iamAkshayrao/LQR-BalanceBot/README.md

# LQR-BalanceBot
LQR-BalanceBot is a two wheel self-balancing robot, based on Arduino Mega. It uses Linear-Quadratic-Regulator, an optimal controller which optimizes a cost function using energy-based method to give optimum gains according to our requirements. A six-state variable state space model has been designed to control position, velocity, yaw (using Quadrature encoders), and tilt angle (using GY-87 sensor) of the bot.

### Video Demonstration ###
https://youtu.be/7lbDvhHPumI

### Results Snapshots

**Traversing slope**

<p float="left">
  
  
    

</p>

**Object pick up and drop**

<p float="left">
  
  
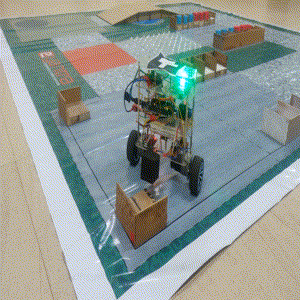
[picture p1: Images/thrid_cut.gif]
    

</p>

**Position hold**

<p float="left">
  

</p>

### Control Architecture
<p float="left">
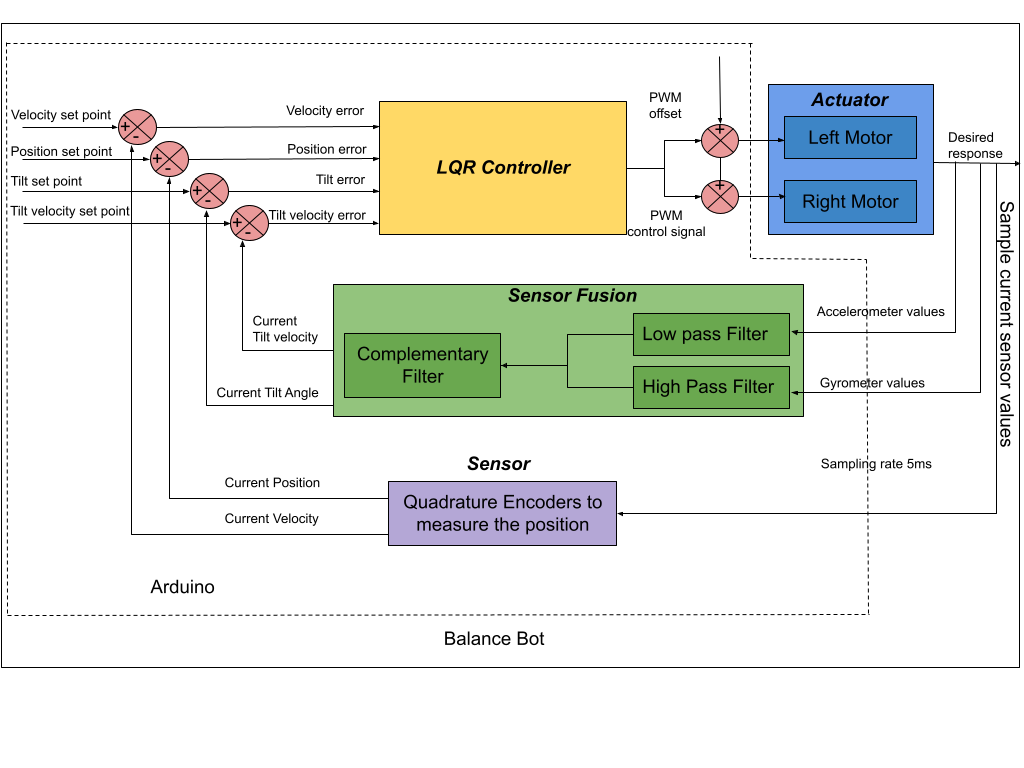
[picture p2: Images/Optimal Control (5).png]
architecture
  
</p>

### Contributors
Akshay, Ali, Ankit, Rehab

### Repository Contents ###
- **Libraries:** Contains MPU and I2C libraries
- **code:** Contains the code for controlling the bot
- **Model:** Contains code files for Mathematical modelling of Robot 
- **Report:** Documentation on the working of the robot and all the task submissions
- **Images:** contains images
