iamAkshayrao/LQR-BalanceBot/References/papers.md

Frankovský, P., Dominik, L., Gmiterko, A., Virgala, I., Kurylo, P. and Perminova, O.. "Modeling of Two-Wheeled Self-Balancing Robot Driven by DC Gearmotors" International Journal of Applied Mechanics and Engineering, vol.22, no.3, 2017, pp.739-747. https://doi.org/10.1515/ijame-2017-0046

Dynamic model of robots: Lagrangian approach Prof. Alessandro De Luca

Adeel, Umar & Alimgeer, Khurram & Inam, Omair & Hameed, Ayesha & Qureshi, Mahmood & Ashraf, Mehmood. (2013). Autonomous Dual Wheel Self Balancing Robot Based on Microcontroller. Journal of Basic and Applied Scientific Research. 3. 843-848. 

https://www.semanticscholar.org/paper/Self-Balancing-Bot-Using-Concept-of-Inverted-Tripathy/ac0a30532ad617de4cc535258583858606950cc2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

Soumya Ramesh. Article: Modelling of Geared DC Motor and Position Control using Sliding Mode Controller and Fuzzy Sliding Mode Controller. IJCA Proceedings on International Conference on Innovations In Intelligent Instrumentation, Optimization and Electrical Sciences ICIIIOES(13):16-23, December 2013

Siradjuddin, Indrazno & Setiawan, Budhy & Fahmi, Ahmad & Amalia, Zakiyah & Erfan, ROHADI. (2017). State space control using LQR method for a cart-inverted pendulum linearised model. 17. 119-126. 

Lundberg, Kent. (2009). History of Inverted-Pendulum Systems. IFAC Proceedings Volumes. 42. 131-135. 10.3182/20091021-3-JP-2009.00025. 

Goher, Khaled & Tokhi, Mohammad. (2010). A New Configuration of Two-Wheeled Inverted Pendulum: A Lagrangian-Based Mathematical Approach. 

https://ctms.engin.umich.edu/CTMS/index.php?example=InvertedPendulum&section=SystemModeling

https://www.coursehero.com/file/12214161/InvertedPendulumOnCartSolution/

The dynamics of a Mobile Inverted Pendulum (MIP). Saam Ostovari, Nick Morozovsky, Thomas Bewley. UCSD Coordinated Robotics Lab.

https://www.mathworks.com/matlabcentral/fileexchange/19147-nxtway-gs-self-balancing-two-wheeled-robot-controller-design
