iamAkshayrao/LQR-BalanceBot/Report/BP_eYRC#9_Task 3.3.pdf

# Biped Patrol

## Task 3.3: Think & Answer

Team Id | 9
College | B.M.S. College Of Engineering
Team Leader Name | Akshay S Rao
e-mail | akshayrao.ec17@bmsce.ac.in
Date | January 15, 2020
Question No. | Max. Marks | Marks Scored
Q1 | 10
Q2 | 20
Q3 | 5
Q4 | 5
Q5 | 5
Q6 | 10
Q7 | 15
Q8 | 8
Q9 | 4
Q10 | 8
Q11 | 10
Total | 100

1

# Biped Patrol

## Task 3.3: Think & Answer

Instructions:

- There are no negative marks.
- Unnecessary explanation will lead to less marks even if answer is correct.
- If required, draw the image in a paper with proper explanation and add the snapshot in your corresponding answer.

Q 1. Describe hardware design for the Medbot, your team is constructing. Describe various
parts with well labeled image. Give reasons for selection of design. | [10]

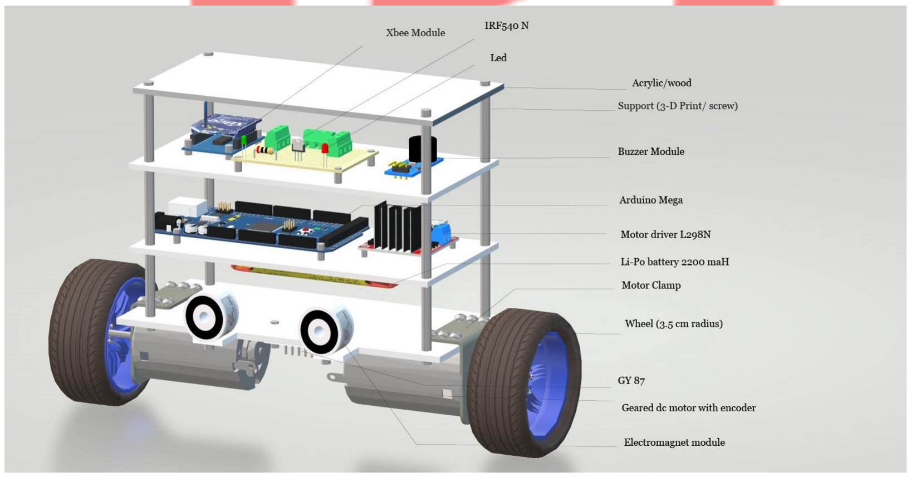
[picture p3: figure]

Figure 1: 3D Model of Medbot

2

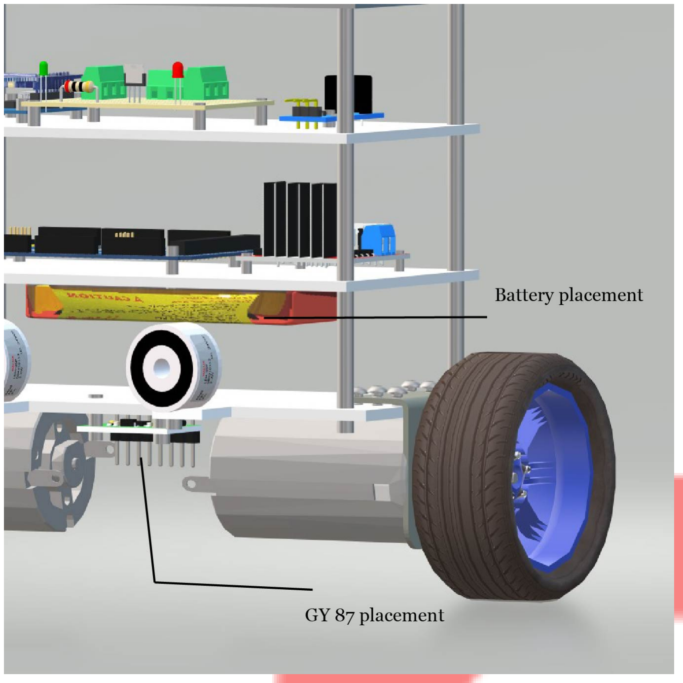
[picture p4: figure]
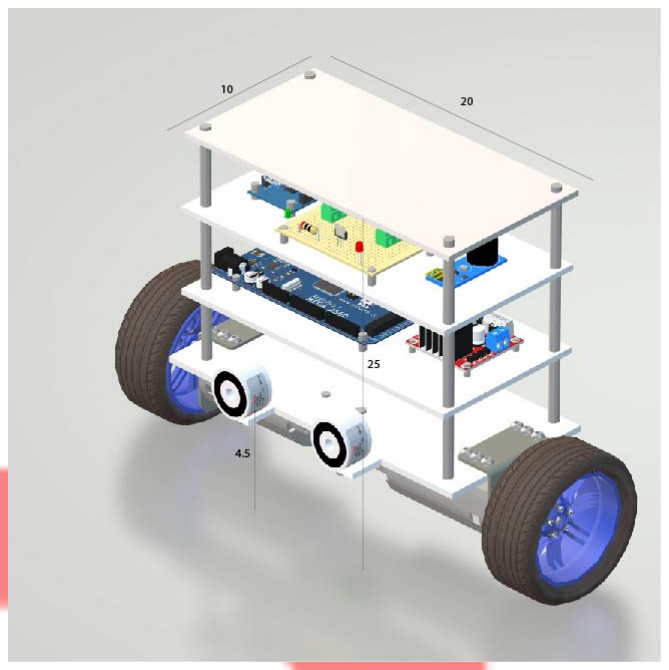
[picture p5: figure]

(a) Gyro and Battery Placement | (b) Dimensions

Figure 2: MedBot from different angles

A 1. Body: Stacked type of design is employed. This helps in varying the position of centre of mass and also helps in programming point of view since the bot has to be tuned many times. To reduce the weight of the body for torque requirement acrylic material is used. The support material is a 3-D printed material.Stack is of size 20x10,The total height of the bot is around 25cm from the bottom.

Gyroscope Placement:GY-87 sensor is placed at the bottom stack along the axis of centre of mass and parallel to the wheel axis.The values measured by the gyroscope is not affected by the placement of the sensor, as it will vary by the same amount at all points on the robot. As the distance from the ground increases, linear acceleration and vibrations, measured at higher points, increases. This could lead to false readings on the accelerometer. Therefore, the sensor is placed at the bottom.

Centre of mass: Mass is distributed in such a way that the position of centre of mass is as low as possible.If the position is too high its stable to disturbances but torque requirement will be very high and lower recovery angle range.By lowering the position we get higher recovery angle and has lesser chance of toppling.From the calculation ,it is at a height of around 14 cm

Electromagnet placement: Electromagnet is placed at the bottom at a height of 4.5cm from the bottom. The centres of the supply iems are at a height of 5cm and 4cm from the arena surface. The average of these height is considered for electromagnet position.

3

Q 2. In Task 1.2, you were asked to model different systems such as Simple Pulley, Complex Pulley, Inverted Pendulum with and without input and stabilizing the unstable equilibrium point using Pole Placement and LQR control techniques. There you had to choose the states; Derive the equations (usually non-linear), find equilibrium points and then linearize around the equilibrium points. You were asked to find out the linear system represented in the form

X˙ (t) = AX(t) + BU(t) | (1)

Where X(t) is a vector of all the state,i.e., X(t) = [x1(t), x2(t), . . . , xn(t)]T , and U(t) is the
vector of input to the system, i.e. U(t) = [u1(t), u2(t), . . . , um(t)]T
. A is the State Matrix & B is the Input Matrix.

In this question, you have to choose the states for the Medbot you are going to design. Model the system by finding out the equations governing the dynamics of the system using Euler-Lagrange Mechanics. Linearize the system via Jacobians around the equilibrium points representing your physical model in the form given in equation 1.
Note: You may choose symbolic representation such as Mw for Mass of wheel, etc. | [20]

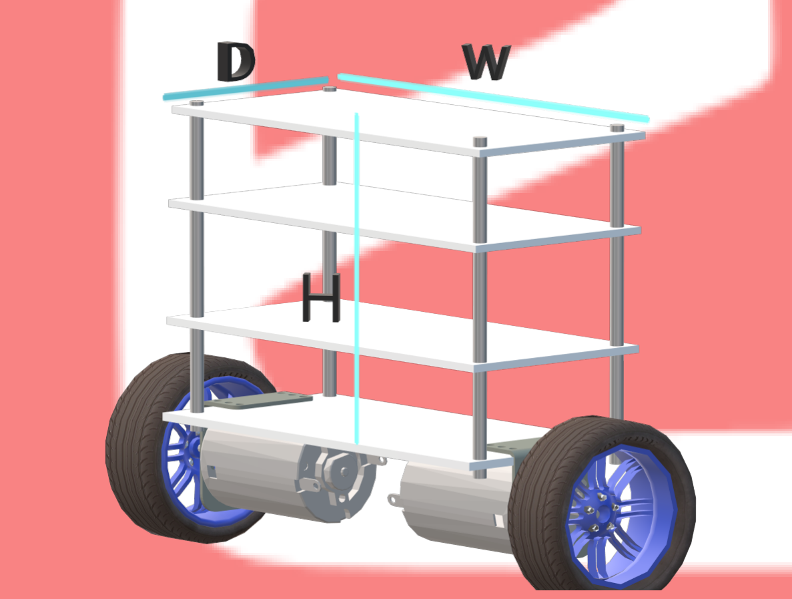
[picture p6: figure]

Figure 3: Medbot

4

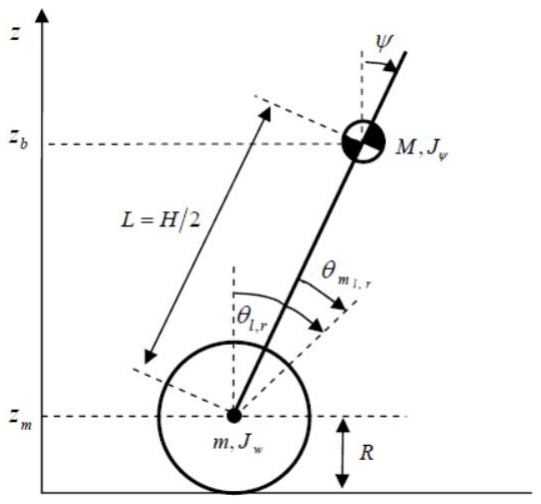
[picture p7: figure]
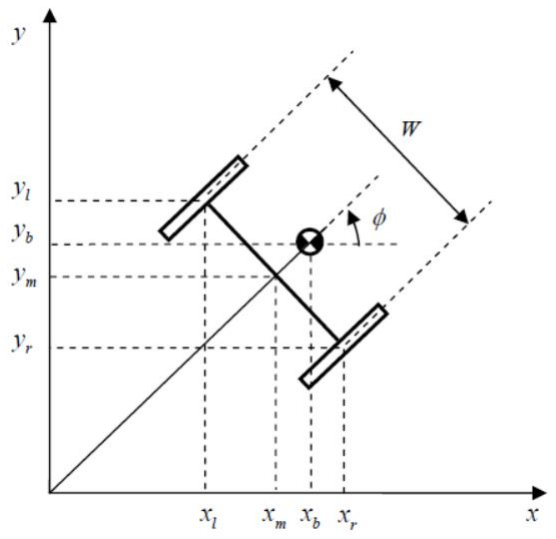
[picture p8: figure]

(a) Top view | (b) Side view

Figure 4: MedBot from different angles

A 2. ψ : body pitch angle; θl,r : wheel angle(l, r indicates left and right)

Physical parameters of the model are the following.
Parameter | Units | Description
g = 9.81 | [m / sec² ] | Acceleration due to gravity
m | [kg] | Wheel mass
R | [m] | Wheel radius
JW | [kg m² ] | Wheel inertia moment
M | [kg] | Body weight
W | [m] | Body width
D | [m] | Body depth
H | [m] | Body height
L | [m] | Distance of the center of mass from the wheel axle
Jψ | [kgm² ] | Body pitch inertia moment
Jφ | [kgm² ] | Body yaw inertia moment
Jm | [kgm² ] | DC motor inertia moment
Rm | [Ω] | DC motor resistance
Kb | [V sec /rad] | DC motor back EMF constant
Kt | [Nm / A] | DC motor torque constant
n | | Gear ratio
fm | | Friction coefficient between body and DC motor
fπ | | Friction coefficient between wheel and floor

5

Equations of Motion Of Two-Wheeled Inverted Pendulum(Medbot).
We can derive equations of motion of two-wheeled inverted pendulum by the Lagrangian method based on the coordinate system in Figure 4. If the direction of two-wheeled inverted pendulum is x-axis positive direction at t = 0, each coordinates are given as the following. (θ, φ) =
1
2

(θl + θr)

R
W

(θr − θl)

(xm, | ym, | zm) = Z
x˙ mdt, | Z
| | | | | y˙mdt, | R
, | ( ˙xm, | y˙m) = (R ˙θ cos φ R ˙θ sin φ)

(xl
, | yl
, | zl) =
xm −
| | | | | W
| | | | | 2
sin φ, | ym +
| | | | | | W
| | | | | | 2
cos φ, | zm

(xr, | yr, | zr) =
xm +
| | | | | W
| | | | | 2
sin φ, | ym −
| | | | | | W
| | | | | | 2
cos φ, | zm

(xb, | yb, | zb) = (xm + L sin ψ cos φ, | ym + L sin ψ sin φ, | zm + L cos ψ)

The translational kinetic energy T1, the rotational kinetic energy T2, the potential energy U
are T1 = | 1
| 2 m
| | x˙
| | 2
l + ˙y

2
| | | | l + ˙z

2
l
| | | | | +
| | | | | 1
| | | | | 2 m
| | | | | x˙
| | | | | 2 r + ˙y
| | | | | 2
r + ˙z
| | | | | | 2 r
| | | | | | + | 1
| | | | | | | 2 M
x˙

2
b + ˙y

2
b + ˙z

2
b

T2 = | 1
| 2 Jw | ˙θ
| | 2 l + | 1
| | | 2 Jw | ˙θ
| | | | 2 r + | 1
| | | | | 2 Jψψ˙ ² +
| | | | | 1
| | | | | 2

Jφφ˙² +

| | | | | | 1
| | | | | | 2 n
| | | | | | 2 | Jm
˙θl − ψ˙

2
+

1
2

n

2
Jm
˙θr − ψ˙

2

U = Mgzb

The fifth and sixth term in T2 are rotation kinetic energy of an armature in left and right DC motor. The Lagrangian L has the following expression.
L = T1 + T2 − U

We use the following variables as the generalized coordinates.
θ | : Average angle of left and right wheel
ψ | : Body pitch angle
φ | : Body yaw angle

The state variables are
[x1 | x2 | x3 | x4 | x5 | x6] = [θ ψ φ | ˙θ ψ˙ | φ˙
]

Lagrange equations are the following.
d

dt
∂L
∂

˙θ

−

∂L
∂θ = Fθ

d

dt
∂L
∂ψ˙
−

∂L
∂ψ = Fψ

d

dt
∂L
∂φ˙
−

∂L
∂φ = Fφ

6

The following equations are found by evaluating the above expressions.

(2m + M)R

2 + 2Jw + 2n

2
Jm

¨θ +
MLR cos ψ − 2n

2
Jm

ψ¨ − MLRψ˙ ²
sin ψ = Fθ
MLR cos ψ − 2n

2
Jm

¨θ +

ML² + Jψ + 2n

2
Jm

ψ¨ − MgL sin ψ − ML²φ˙²
sin ψ cos ψ = Fψ
1
2

mW² + Jφ +

W²
2R²
Jw + n

2
Jm

+ ML²

sin² ψ

φ¨ + 2ML²ψ˙φ˙ sin ψ cos ψ = Fφ

In consideration of DC motor torque and viscous friction, the generalized forces are given as the following
(Fθ, | Fψ, | Fφ) =
Fl + Fr, | Fψ,

W
2R

(Fr − Fl)

Fl = nKtil + fm

ψ˙ − ˙θl
− fw

˙θl

Fr = nKtir + fm

ψ˙ − ˙θr
− fw

˙θr

Fψ = −nKtil − nKtir − fm

ψ˙ − ˙θl
− fm
ψ˙ − ˙θr

where il,r is the DC motor current. We cannot use the DC motor current directly in order to control it because it is based on PWM (voltage) control. Therefore, we evaluate the relation between current il,r and voltage vl,r using DC motor equation. If the friction inside the motor is negligible, the DC motor equation is generally as follows

Lmil,r = vl,r + Kb

ψ˙ − ˙θl,r
− Rmil,r

Here we consider that the motor inductance is negligible and is approximated as zero. Therefore the current is

il,r =

vl,r+Kb(ψ˙− ˙θl,r)

Rm

The generalized force can be expressed using the motor voltage. Fθ = α (vl + vr) − 2 (β + fw)

˙θ + 2βψ˙

Fv = −α (vl + vr) + 2β ˙θ − 2βψ˙

Fφ =

W
2R

α (vr − vl) −

W²
2R²

(β + fw) φ˙

α =

nKt
Rm

, β =

nKtKb
Rm

+ fm

To find the expressions for ¨θ ψ¨ φ¨ the following notations are used. A = (2m + M)R

2 + 2Jw + 2n

2
Jm + 2(β + fw)
B = MLR cos ψ − 2n

2
Jω
C = ML² + Jψ + 2n

2
Jm

D =

1
2

mW² + Jφ +

W²
2R²
Jω + n

2
Jm

+ ML²

sin² ψ

7

The derivatives of the state variables without linearization are expressed by ˙θ =

dθ
dt
ψ˙ =

dψ
dt
φ˙ =

dφ
dt

¨θ =

Fθ + MLRψ˙ 2
sin ψ
(ML² + Jψ + 2n

2Jm) − B

h
Fψ + MgL sin ψ + ML²φ˙2
sin ψ cos ψ

i

AC − B²

ψ¨ =

A

h
Fψ + MgL sin ψ + ML²φ˙2
sin ψ cos ψ

i
− B

h
Fθ + MLRψ˙ 2
sin ψ

i

AC − B²

φ¨ =

W
2R

α (vr − v1) −

W²
2R² (β + fw) − 2ML²

sin ψ cos ψφ˙ψ˙

D

From the above expressions Jacobian is given by J =

0 | 0 | 0 | 1 | 0 | 0
0 | 0 | 0 | 0 | 1 | 0
0 | 0 | 0 | 0 | 0 | 1
0 J(1, 1) 0 J(1, 2) J(1, 3) J(1, 4) 0 J(2, 1) 0 J(2, 2) J(2, 3) J(2, 4)
0 J(3, 1) 0 | 0 | J(3, 2) J(3, 3)

J(3, 1) = −ML²Dψ˙φ˙2 cos 2ψ−(numerator(φ¨))(ML²

sin 2ψ)

D²

J(3, 2) = −2ML²φ˙ sin ψ·cos ψ D
J(3, 3) = −W²
2R² (β + fw) − 2ML²ψ˙ cos ψ sin ψ/D

J(2, 4) = 2AML²φ˙ sin ψ cos ψ
AC−B²
J(2, 3) = −2β(A+B)−2BMLRψ˙ sin ψ AC−B²
J(2, 2) = 2B(β+fω)+2Aβ
AC−B²
J(1, 2) = −2(β+fω)C−2βB
AC−B²
J(1, 3) = (2β+2MLRψ˙ sin ψ)C+2βB AC−B²
J(1, 4) = −2ML²sinψ cos ψφB˙ AC−B²
J(2, 1) = ((AC−B²

)[A(MgL cos ψ−4ML²φ˙2 cos 2ψ)−B(MLRψ˙ 2 cos ψ)+[Fθ+MLRψ˙ 2
sin ψ][MLR sin ψ]−
(numerator(ψ¨)(2B)(MLRSinψ))/[AC − B² ]

2
J(1, 1) = (AC − B²
)

h
MLRψ˙cos²ψ (ML² + Jψ + 2n
2Jm) − B

h
MgL cos ψ + 2ML²φ˙2 cos(2ψ)

i
+

h
Fψ + MgL sin ψ +

(numerator(

¨θ))(2BMLR sin ψ)]/[AC − B² ]

2

Linearization and State-Space Representation
The derivatives of the state variables are equated to zero to find the equilibrium points. The

8

equilibrium points found are when pitch angle ψ is 0 or π from the positive z axis and the derivatives of the state variables are 0.
Since point ψ = 0 from vertical is unstable equilibrium,Jacobian is linearized around this point.After substituting the equilibrium points in the Jacobian ,the following state space representation is obtained.

X˙ = A0X + B0U

where, X =

θ ψ φ ˙θ ψ φ >

U =

vl vr

>

E =

(2m + M)R² + 2Jv + 2n

2Jm MLR − 2n 2Jm
MLR − 2n
2Jm | ML² + Jψ + 2n

2Jm

A0 =

0 | 0 | 0 | 1 | 0 | 0
0 | 0 | 0 | 0 | 1 | 0
0 | 0 | 0 | 0 | 0 | 1
0 x(1, 1) 0 x(1, 2) x(1, 3) | 0
0 x(2, 1) 0 x(2, 2) x(2, 3) | 0
0 | 0 | 0 | 0 | 0 | x(3, 1)

x(1, 1) = −gMLE(1,2)
det(E)
x(1, 2) = −2[(β+fw)E(2,2)+βE(1,2)] det(E)
x(1, 3) = 2β[E(2,2)+E(1,2)] det(E)
x(2, 1) = gMLE(1,1)
det(E)
x(2, 2) = 2[(β+fw)E(1,2)+βE(1,1)] det(E)
x(2, 3) = −2β[E(1,1)+E(1,2)] det(E)
x(3, 1) =

W2
2R2

(β+fw)

1

2mW²+Jφ+ W2
2R2

(JW +n²Jm)

B0 =

0 | 0
0 | 0
0 | 0
B0(4) | B0(4)
B0(5) | B0(5)
−B0(6) B0(6)

B0(4) = α[E(2,2)+E(1,2)]
det(E)
B0(5) = −α[E(1,1)+E(1,2)]
det(E)
B0(6) = | W α
2R

h
1

2mW²+Jφ+ W2
2R2

(Jw+n²Jm)

i

9

Q 3. Equation 1 represents a continuous-time system. The equivalent discrete time system is represented as:
X(k + 1) = AdX(k) + BdU(k) | (2)

Where X(k) is a measure of the states at kth sampling instant,i.e., X(k) = [x1(k), x2(k), . . . , xn(k)]T
,
and U(k) is the vector of input to the system at kth sampling instant, i.e. U(k) = [u1(k), u2(k), . . . , um(k)]T .
Ad is the Discrete State Matrix & Bd is the Discrete Input Matrix.

What should be the position of eigen values of Ad for system to be stable.
Hint: In frequency domain, continuous-time system is represented with Laplace transform and
discrete-time system is represented with Z transform. | [5]

A 3. The Laplace transform in frequency domain is used to construct any aperiodic finite signal using growing or damped complex exponentials of continuous frequencies from zero to infinity. The laplace tranform is given by

F(s) = R ∞
0

f(t)e

−stdt

where, s = σ + jω

We can find the system transfer function using the state space equations under zero state conditions.The real part of the roots of the system transfer function should be negative, so that after convolution the output of the system is finite thereby meaning stable.

In z domain it is similar case but the continuous time signal is sampled with a period Ts, but z = rejω , so here the abs(z) should be lesser than one so that system is stable.

X(z) = Z{x[n]} =

P∞
n=−∞ x[n]z

−n

Hence the eigenvalues represent the s and z values of continuous and discrete case respectively of the system transfer function under zero state condition. Therefore for discrete case, the abs(eigenvalues) should be lesser than one for the system to be stable.

If the real part of the s parameter is zero then it corresponds to the Y axis in the σ − jω plane which corresponds to the unit circle in the z plane.

The system is stable if Ts>0 and the eigenvalues are within the unit circle, as determined by this statement:

10 all(abs(eig(Ad))) < 1 where Ad = T A0 + I considering Euler’s transformation.

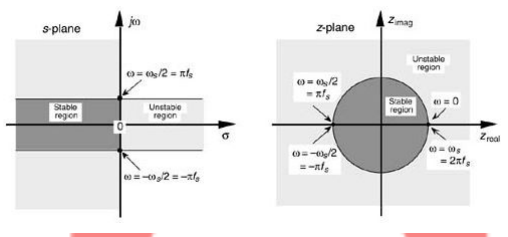
[picture p9: figure]

Q 4. Will LQR control always works? If No, then why not? and if Yes, Justify your answer.
Hint: Take a look at definition of Controllable System. What is controllability? | [5]

A 4. No. LQR controllers are controllers that provide input that can steer a particular system from some initial point at x0 at t=0 to any state xf inal at t=n. If the controllability matrix has rank less than the number of state variables then the system is said to be uncontrollable. Hence if system is controllable then only can we use LQR controllers. Also when the the specifications of the components do not meet the requirement of the LQR, LQR might work but the desired state cannot be obtained and hence it will become uncontrollable.

Q 5. For balancing robot on two wheel i.e. as inverted pendulum, the center of mass should
be made high or low? Justify your answer. | [5]
A 5. | • The torque equation is given by | τ = MgL sin θ.
- Here Mg is weight of the body and L is the distance of the centre of mass from the wheel
| axis.
- According to the equation when L increases,torque applied by the body increases, to counter this torque ,the torque requirement of motor increases. Hence to reduce the torque requirement the position of centre of mass is made low in our design.
- Also from the equation ,θ can be more as L is made less, so the bot can balance itself for
| large angular displacement.

11

Q 6. Why do we require filter? Do we require both the gyroscope and the accelerometer for
measuring the tilt angle of the robot? Why? | [10]

A 6. We require filter to remove noise signals which is induced by the mechanical vibrations and also to complement for the disadvantage present in acquiring signals in accelerometer and gyroscope.

Accelerometer
An accelerometer is used to measure the inertial force which is directed in the opposite direction of the acceleration vector. It measures force and not acceleration but it happens that acceleration also causes an inertial force which is captured by the force detecting mechanism of the accelerometer. We need to calculate pitch using the accelerometer which can be done using the formula

pitch = atan2(accx, sqrt(accy² + accz² ))

Disadvantages.

1. Pure yaw angles cannot be calculated from just a accelerometer because Z will be perfectly perpendicular to the plane of motion.
2. Accelerometer experiences translational accelerations too. These will add additional acceleration values and so the orientation values obtained won’t be the actual one.
3. Accelerometer alone used to measure the pitch angle will be very noisy. The platform is horizontal, but the motors are causing it to accelerate forward. The accelerometer cannot distinguish this from gravity.

Hence we use a low pass filter to filter out the short duration horizontal acceleration so that only the long term acceleration is captured that is gravity. However, the con of this is that Angle measurement will lag due to the averaging. The more it is filtered, the more it will lag. Hence a sudden change or a large change cannot be detected easily since it is averaged before.

Gyrometer
The gyroscope measures the angular velocity of the body frame with respect to the inertial frame, expressed in the body frame. Hence to find the angular displacement, we have to integrate the angular velocity.

Advantages and disadvantages

1. The gyrometer provides the orientation estimates at high sampling rates which are accurate on a short time scale but drift over longer time scales due to integration drift.

12

2. If we measure a quantity which is zero using a non-perfect sensor, in case our measurements are corrupted by a constant bias, integration of these measurements will lead to a signal which grows linearly with time. If the sensor instead measures a zero-mean white noise signal, the expected value of the integrated measurements would be zero, but the variance would grow with time.

If we pass the angle obtained through a high pass filter we will obtain value for the angle measurement but it will be plagued by the variance due noise.

Hence we use a complementary filter where we pass the angle estimated by the accelerometer through a low pass filter (good estimation of the static conditions) and gyrometer through a high pass filter(good estimation of the dynamic conditions) and combine the results.

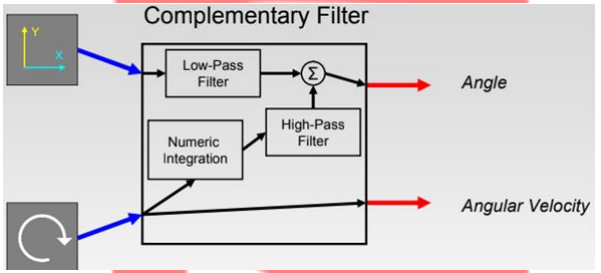
[picture p10: figure]

Figure 5: Complementary filter to obtain angular displacement and velocity

Q 7. What is Perpendicular and Parallel axis theorem for calculation of Moment of Inertia?
Do you require this theorem for modelling the Medbot?Explain Mathematically. | [15]

13

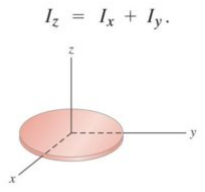
[picture p11: figure]

(a) Parallel Axis theorem | (b) Perpendicular Axis Theorem

Figure 6

A 7. Parallel Axis Theorem
Suppose a body of mass m is rotated about an axis z passing through the body’s centre of gravity. The body has a moment of inertia Icm with respect to this axis. The parallel axis theorem states that if the body is made to rotate instead about a new axis z

0 which is parallel
to the first axis and displaced from it by a distance d, then the moment of inertia I with respect to the new axis is related to Icm by
I = Icm + md²

Explicitly, d is the perpendicular distance between the axes z and z

0

Perpendicular Axis Theorem
The perpendicular axis theorem states that the moment of inertia of a plane lamina about an axis perpendicular to the plane of the lamina is equal to the sum of the moments of inertia of the lamina about the two axes at right angles to each other, in its own plane intersecting each other at the point where the perpendicular axis passes through it.
Define perpendicular axes x, y, and z (which meet at origin O ) so that the body lies in the xy plane, and the z axis is perpendicular to the plane of the body. Let lx, ly and lz be moments of inertia axis x, y, z respectively, the perpendicular axis theorem states that [1]

Iz = Ix + Iy

Yes, we use parallel axis theorem in the derivation.

14

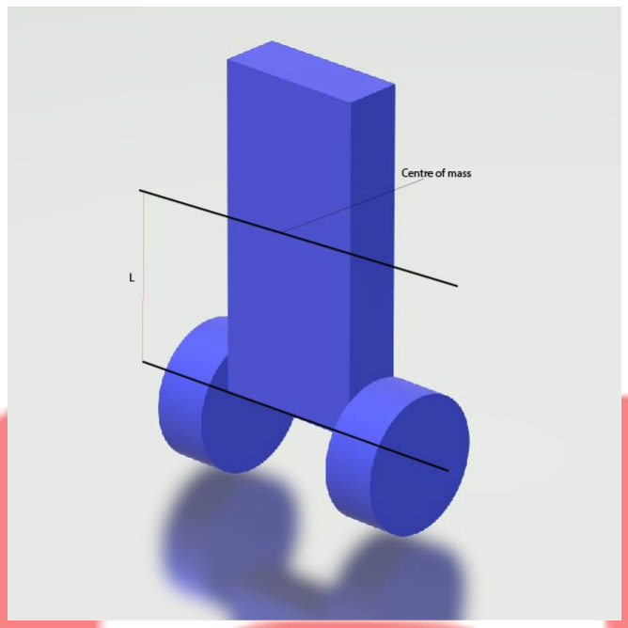
[picture p12: figure]

Figure 7: Medbot

1. Jψ = ML²/3, this is the moment of inertia of the body about its center of mass when axis is orthogonal to the height.Here the length of the body(H) is considered to be (2L).
2. The moment of inertia of a rectangular plane about its center of mass when axis is orthogonal to its height is MH²/12, but H=2L.
3. Therefore moment of inertia was found to be M(2L)

2/12 = ML²/3.

As seen in ‘C’ term in answer of question 2 we get ML² + Jψ + 2n

2Jm.Here Jψ term is getting added to ML² where L is the distance of the body’s centre of mass from the wheel axle. Wheel axle is the pitch axis of rotation of the Medbot.
Also Jψ is moment of inertia of the body when the axis of rotation passes through the centre of mass orthogonal to its height. Therefore we use parallel axis theorem to bring the axis of rotation to the wheel axle by adding the moment of inertia about the center of mass Jψ with ML²

Q 8. What will happen in the following situations:

(a) Medbot picks a First-Aid Kit from the shelf of Medical Store but the First-Aid Kit falls inside the store. Will there be any penalty imposed, points awarded? Will the First-Aid
Kit be repositioned? | [2]
(b) Medbot picks a First-Aid Kit from the shelf of Medical Store but the First-Aid Kit falls outside the store. Will there be any penalty imposed, points awarded? Will the First-Aid
Kit be repositioned? | [2]

15

(c) Medbot picks a First-Aid Kit from the shelf of Medical Store but the First-Aid Kit and the Medbot both fall inside the store. Will there be any penalty imposed, points awarded?
Will the First-Aid Kit be repositioned? | [2]
(d) Medbot picks a First-Aid Kit from the shelf of Medical Store but the First-Aid Kit and the Medbot both fall outside the store. Will there be any penalty imposed, points awarded?
Will the First-Aid Kit be repositioned? | [2]

A 8. What will happen in the following situations:

(a) No, Penalty is not imposed. First-Aid Kit is repositioned.
(b) Penalty is not imposed. A pick-up is successful if the item is carried out of the store, since FAK kit fell outside the store, this is considered successful pick-up and 20 points are awarded. First-Aid Kit is repositioned.
(c) A fall penalty of 50 points are imposed. Points are not awarded. First-Aid kit is repositioned.
(d) A fall penalty of 50 points are imposed. This is a successful pick-up, so 20 points are awarded. First-Aid kit is repositioned.

Q 9. What will be the points awarded if Medbot picks only one of the item from the medical store and repeatedly moves back and forth around the gravel pathway or the bridge for the
entire run. | [4]

A 9.

1. Initially if the Medbot goes to store to pick-up an item through gravel pathway
- Marks awarded for traversing the bridge, MB = 70 ∗ (1) = 70.
- Marks awarded for traversing the gravel pathway, MG = 50 ∗ (0.5 ∗ 1 + 1) = 75.
- Marks awarded for Successful pick-up = 20
- Total = 165.
2. Initially if the Medbot goes to store to pick-up an item by crossing the bridge.
- Marks awarded for traversing the bridge, MB = 70 ∗ (0.5 ∗ 1 + 1) = 105.
- Marks awarded for traversing the gravel pathway, MG = 50 ∗ (1) = 50.
- Marks awarded for Successful pick-up = 20
- Total = 175.
3. Initially if the Medbot goes to store to pick-up an item by passing through the pathway
| 16

where rooms are present.

- Marks awarded for traversing the bridge, MB = 70 ∗ (1) = 70
- Marks awarded for traversing the gravel pathway, MG = 50 ∗ (1) = 50.
- Marks awarded for Successful pick-up = 20
- Total = 140.

Q 10. What are the different communication protocols you’ll be using? Name the hardware interfaced related to each of the communication protocols. Explain how these communication
protocols works and what are the differences between them. | [8]

A 10. The different communication protocols we use for the Medbot include:

### 1. Universal Asynchronous Receiver/Transmitter (UART) for serial communica-

tion between the Xbee S2C module and the Arduino Mega.

### 2. Inter-Integrated Circuit (I2C) communication protocol for communication be-

tween the GY-87 module and the Arduino Mega.

### 3. The communication protocol used to communicate between the two Xbee mod-

ules is based upon IEEE 802.15.4 standard.

Working

1. It is used for asynchronous serial communication in which the data format and transmission speeds are configurable. The electric signaling levels and methods are handled by a driver circuit external to the UART. A UART is usually an individual (or part of an) integrated circuit (I

2C) used for serial communications over a computer or peripheral device serial port. There are three hardware serial ports in Arduino Mega.

Data frame of UART

Start bit: The UART data transmission line is normally held at a high voltage level when it’s not transmitting data. To start the transfer of data, the transmitting UART pulls the transmission line from high to low for one clock cycle. When the receiving UART detects the high to low voltage transition, it begins reading the bits in the data frame at the frequency of the baud rate.
Data Frame: The data frame contains the actual data being transferred. It can be 5 bits up to 8 bits long if a parity bit is used. If no parity bit is used, the data frame can be 9 bits long. In most cases, the data is sent with the least significant bit first.
Parity: If the parity bit is a 0, and the total is odd; or the parity bit is a 1, and the total is even, the UART knows that bits in the data frame have changed.
| 17

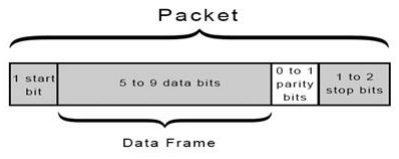
[picture p13: figure]

Figure 8: Data frame of UART

Stop bits: To signal the end of the data packet, the sending UART drives the data transmission line from a low voltage to a high voltage for at least two bit durations.

2. I

2C is a synchronous, multi-master, multi-slave, packet switched, single-ended, serial computer bus. In I

2C , there can be more than one master, only upper bus speed is defined and only two wires with pull-up resistors are needed to connect almost unlimited number of I

2C
devices. I2C can use even slower microcontrollers with general-purpose I/O pins since they only need to generate correct Start and Stop conditions in addition to functions for reading and writing a byte. Each slave device has a unique address. Transfer from and to master device is serial and it is split into 8-bit packets. The initial I

2C specifications defined maximum clock frequency of 100 kHz. This was later increased to 400 kHz as Fast mode.

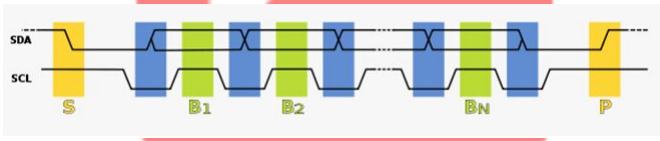
[picture p14: figure]

Figure 9: I2C Protocol

- In normal state both lines (SCL and SDA) are high. The communication is initiated by the master device. It generates the Start condition (S) followed by the address of the slave device (B1).
- If the bit 0 of the address byte was set to 0 the master device will write to the slave device (B2). Otherwise, the next byte will be read from the slave device.
- Once all bytes are read or written (Bn) the master device generates Stop condition (P). This signals to other devices on the bus that the communication has ended and another

18

device may use the bus.

Most I2C devices support repeated start condition. This means that before the communication ends with a stop condition, master device can repeat start condition with address byte and change the mode from writing to reading.

3.

- IEEE 802.15.4 is a technical standard which defines the operation of low-rate wireless personal area networks (LR-WPANs).
- The 802.15.4 standard specifies that communication should occur in 5 MHz channels ranging from 2.405 to 2.480 GHz.Only approximately 2 MHz of the channel is consumed with the occupied bandwidth.
- In the 2.4 GHz band, a maximum over-the-air data rate of 250 kbps is specified, but due to the overhead of the protocol the actual theoretical maximum data rate is approximately half of that.
- ZigBee is a higher latency, lower bandwidth, asynchronous protocol that uses the 802.15.4 standard as a baseline and adds additional routing and networking functionality. We use the Xbee in API mode with sample rate of 10ms to obtain the information from the remote at the Medbot.

Differences

1. UART is typically for a point to point connection, I2C is a bus protocol
2. UART is (can be) full duplex, I2C is not
3. UART does not have a master/slave principle (no protocol), I2C has
4. UART can be used for transmission over distance, I2C is not meant for that.

Q 11. Why do we require IRF540N? Provide circuit diagram for interfacing IRF540N with the
microcontroller. | [5+5]

19

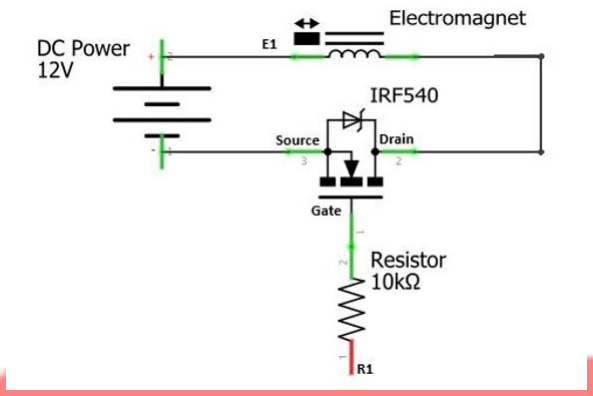
[picture p15: figure]

Figure 10: Electromagnet and MOSFET connection circuit.

A 11. • Electromagnet needs good amount of current for it produce good amount of magnetic field. But Arduino pins are capable of delivering a maximum current of 40mA which
is quite less.
- Hence the electromagnet is powered by the LiPo battery source directly and use IRF540N(MOSFET) as a voltage controlled switch which is capable of delivering 23A at 100oC and VGS = 10V
with the gate as the pin from the Arduino to control the current.

IRF540N has high power dissipation capability since it’s a power N channel MOSFET .If connected directly, the current drawn will be near maximum and there maybe unnecessary resets in the Arduino due to it. When the VGS is high(control input) the MOSFET acts as short circuit and the Electromagnet is turned ON. When the VGS is low the MOSFET acts as open circuit and the entire voltage drop is across the transistor and the Electromagnet is turned OFF. In the above figure R1 is connected to the microcontroller.

20
