iamAkshayrao/LQR-BalanceBot/Report/BP_eYRC#9_Task1_analysis.pdf

# Think and Answer

## e-YRC#9

Team leader name | AKSHAY S RAO
College | B.M.S. COLLEGE OF ENGINEERING
Email | akshayrao.ec17@bmsce.ac.in
Date | 26 – 11 - 2019

Please answer all the questions given below. You are allowed to use figures or diagrams to support your answer. Since these questions test your understanding of the whole subject, please refrain from directly asking for answers on Piazza.

## Section 1 - Simple Pendulum

Q1) Find the eigenvalues of Simple Pendulum at equilibrium point (0,0). Is the system
stable or unstable at this point? | (2)

To find Eigen values we have to find |A − λI| and solve for λ.

Matrix A at (0, 0) is given by, A = [

0 1
−g/l 0

]

|A − λI| = |[

−λ 1
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
→ λ = ±i√

g
l

Code - [eigen_value] = eig(A);

The system is stable at point (0, 0).

Q2) Can the Pendulum be balanced at an arbitrary point such as (2π/3, 0) using the Pole
Placement or LQR controller? Why? Why Not? Justify your answer. | (3)

We try to make a closed loop controller with overall eigen values on the left half of the complex plane irrespective of the eigen values of the open loop system, hence the system will be stable for any input hence the Pendulum can be balanced at an arbitrary point using both Pole Placement and LQR controller.

Proof :

Controllability is the ability to drive a state from any initial value to a final value in finite amount of time by providing a suitable input. If we have a system which is controllable, then we can place its eigenvalues anywhere in the left half plane by choosing appropriate gain matrix K.

For simple pendulum,

A = [

0 1
g
l

0

] B = [

0
1
ml

2

] R = [ B AB]

AB = [

1
ml

2
0

]

So R = [
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
Since the rank of the matrix is two and so is the number of state variables, the system is controllable and therefore the system can be driven to any arbitrary point.

## Section 2 - Mass Spring System

Q3) Derive the equations of Mass Spring system. | (3)

Let m be the mass of the block, k be the spring constant, x and ẋ be the displacement and velocity respectively.

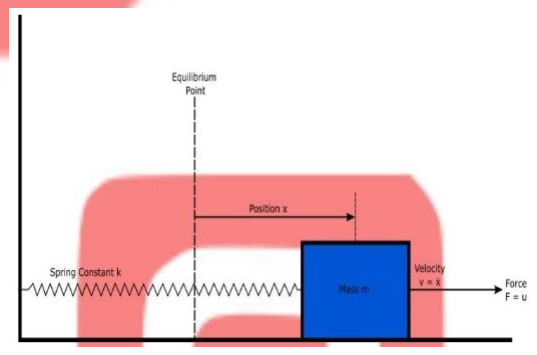
[picture p16: figure]

We know that Langrangian L = K.E – P.E

K.E = 1
2

mẋ

2

P.E = 1
2

kẋ

2

L = 1
2

mẋ

2

1
2

kẋ

2

### Tℎe Euler − Lagrange equation is

d
dt (

∂L
∂ẋ

) −

∂L
∂x = F − − (1)

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
(mẋ) = mẍ − − (2)

∂L
∂x = −kx | − − (3)

### from 2 & 3 (1) → mẍ+ kx = F

ẍ= −

k
m

x +

F
m
So the states are given by, | x1 = x | x2 = ẋ
Derivative of state variables are given by, ẋ1 = x2 | ẋ2 = ẍ= −

k
m

x1 +

F
m

Q4) Is the mass spring system a linear system or non-linear? Justify your answer. (1)

It is linear system since it can be represented in the standard form ẋ=Ax+Bu where x is the state variable and u is the input. The system is linear for all positions of x and no small regions is taken for the analysis. This is a linear system because all of its terms are single, first-degree variables with constant coefficients.

Q5) Can the mass spring system be driven to arbitrary state (0.8, 0) using pole
placement controller? (Assuming 0.8 is the position and 0 is the velocity). | (1)

Yes, pole placement controller can be used to drive the mass spring system to an arbitrary state since the state equations is linear for all values of the state variables. We try to make a closed loop controller with overall eigenvalues on the left half of the complex plane irrespective of the eigenvalues of the open loop system.

Proof:

For simple pendulum,

A = [

0 1
−k
m

0

] B = [

0
1
m

] R = [ B AB]

AB = [

1
m
0

]

So, R = [
0

1
m
1
m

0

]

Since the rank of the matrix is two and so is the number of state variables, the system is controllable and therefore the system can be driven to any arbitrary point.

## Section 3 - Simple Pulley

Q6) Under what conditions, will the system remain perfectly at rest? Justify your
answer. | (1)

For input = 0 and m1 = m2 there will be no net acceleration, so the system will be at rest.

Q7) How many equilibrium points does the system have? Are they stable or unstable?
Justify your answer. | (2)

For the simple pulley to be at equilibrium, T = 0

ẋ1 = x2 = 0 & ẋ2 =

(m1−m2

)g+

T
r
m1+m2

= 0 → m1 = m2

Only condition for equilibrium is m1 = m2 which is irrespective of the position of the mass.

Its stable equilibrium,

proof → A matrix = [

0 1
0 0

]

Its eigenvalues are ±0 which is stable.

## Section 4 - Complex Pulley

Q8) Derive the equations of motion for the complex pulley system. | (5)

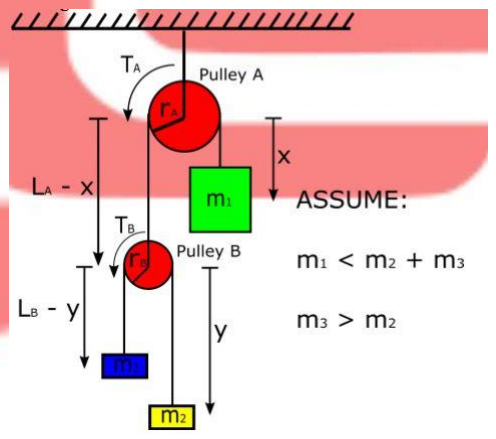
[picture p17: figure]

Let v1 be the velocity of mass m1

v2 be the velocity of mass m1

v3 be the velocity of mass m3

Let x1 = x , x2 = ẋ, x3 = y, x4 = ẏ

→ ẋ1 = x2, ẋ3 = x4

Assuming m1 < m2 + m3 and m3 > m2

v1 = −ẋ ; v2 = ẋ − ẏ ; v3 = ẋ + ẏ

K.E = 1
2

m1ẋ

2 +

1
2

m2

(ẋ − ẏ)

2 +

1
2

m3

(ẋ + ẏ)

2

P.E = −m1gx − m2g(LA − x + y) − m3g(LA − x + LB − y)

We know that Lagrangian, L = K.E – P.E.

L =

1
2

m1ẋ

2 +

1
2

m2

(ẋ − ẏ)

2 +

1
2

m3

(ẋ + ẏ)

2 + m1gx + m2g(LA − x + y)

+ m3g(LA − x + LB − y)

The Euler − Lagrange equations for this system is given by,

d
dt (

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
− − (1)

d
dt (

∂L
∂ẏ

) −

∂L
∂y =

TB
rB

− − (2)
(

∂L
∂ẋ

) = m1ẋ + m2
(ẋ − ẏ) + m3

(ẋ + ẏ) = (m1 + m2 + m3

)ẋ + (−m2 + m3
)ẏ

d
dt (

∂L
∂ẋ

) = (m1 + m2 + m3
)ẍ+ (−m2 + m3
)ÿ | − − (3)

∂L
∂x
= m1g − m2g − m3g | − − (4)

∂L
∂ẏ

= −m2

(ẋ − ẏ) + m3

(ẋ + ẏ) = (−m2 + m3

)ẋ + (m2 + m3

)ẏ

d
dt (

∂L
∂ẏ

) = (−m2 + m3
)ẍ+ (m2 + m3

)ÿ − − (5)

∂L
∂y = m2g − m3g | − −(6)

(3), (4) in (1) & (5), (6) in (2) →

(m1 + m2 + m3

)ẍ+ (−m2 + m3

)ÿ= (m1−m2−m3

)g +

TA
rA

− − (7)

(−m2 + m3

)ẍ+ (m2 + m3

)ÿ= (m2−m3

)g +

TB
rB

− − (8)

Solving for ẍ & ÿ we get,

ẋ2 = ẍ=

(m1m2 + m1m3 − 4m2m3

)g
m1m2 + m1m3 + 4m2m3

+

(
TA
rA

(m2 + m3

)−

TB
rB

(−m2 + m3

))

(m1m2 + m1m3 + 4m2m3

)

− − (9)

ẋ4 = ÿ=

(2m1m3 − 2m1m2

)g +

TA
rA

(−m2 + m3

) −

TB
rB

(m1 + m2 + m3

)

(m1m2 + m1m3 + 4m2m3

)

Q9) Derive the A and B matrices for the complex pulley system. Is the system linear or
non linear? | (4)

The system is non-linear since it doesn’t obey superposition principle (it involves some constants which affects linearity).

From the equations derived above ẋ1 = x2, ẋ3 = x4, ẋ4 & ẋ2 refer (9) above

A =

[

∂ẋ1
∂x1

∂ẋ1
∂x2

∂ẋ1
∂x3

∂ẋ1
∂x4
∂ẋ2
∂x1

∂ẋ2
∂x2

∂ẋ2
∂x3

∂ẋ2
∂x4
∂ẋ3
∂x1

∂ẋ3
∂x2

∂ẋ3
∂x3

∂ẋ3
∂x4
∂ẋ4
∂x1

∂ẋ4
∂x2

∂ẋ4
∂x3

∂ẋ4
∂x4]

A = [

0 1 0 0
0 0 0 0
0 0 0 1
0 0 0 0

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
→ B =

1
m1m2+m1m3+4m2m3

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
- | + | +
+ | -
A | B
A | B

r

m | m | m
r

m m

r

m m
r
m | m
2 | 3 | 1 | 2 | 3
2 | 3 | 2 | 3
0 | 0
0 | 0

Q10) Under what conditions, will the system remain perfectly at rest? Justify your
answer. | (3)

### When m1 = 2m2 = 2m3

For rest condition,

ẋ, ẏ , ẍ, ÿ, TA, TB = 0

When this happens,

(m1m2 + m1m3 − 4m2m3 | ) = 0 − −(1)

(2m1m3 − 2m1m2

) = 0 − −(2)

from (2) m2 = m3 − − (3)

(2) in 1 → m1 = 2m2

## Section 5 - Inverted Cart Pendulum

Q11) Derive the equations of motion for the inverted cart pendulum system. Is this
system linear or non-linear? Why? | (7)

This system is non-linear since the equations representing the dynamics of the system doesn’t obey superposition principle, also from the equation 7 and 8 derived below we can see derivative of the state variables are sinusoidal functions of ɵ, we can’t represent these type of equations in A = Bx form .

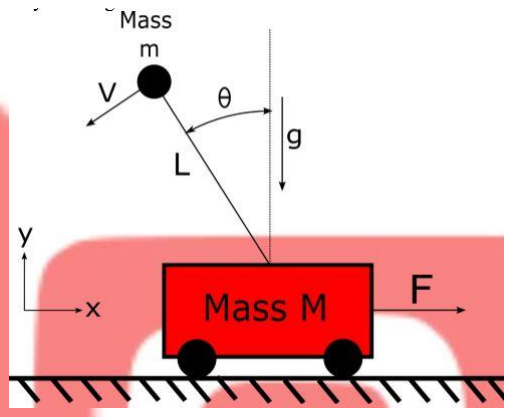
[picture p18: figure]

The states are given by

x1 = x x2 = ẋ x3 = ɵ x4 = ɵ̇

Where x is position of the cart.

ẋ is velocity of the cart.

ɵ is angular displacement of the pendulum from vertical.

ɵ̇ is the tangential angular velocity of the pendulum.

Let [

ẋ1
ẋ2
ẋ3
ẋ4
] be the derivative of state variable vector, where ẋ1 = x2 | ẋ3 = x4
We know that Lagrangian | L = K.E – P.E.

Let M - mass of the cart, m – mass of the pendulum, l = length of the pendulum.

Kinetic energy of the system =

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
m(ɵ̇x

2 + ɵ̇y

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
m(ẋ − lɵ̇ cos ɵ)

2 +

1
2

m(−lɵ̇ sin ɵ)

2

=

1
2

(m + M)ẋ

2 +

1
2

m(−2ẋlɵ̇cosɵ + l

2ɵ̇

2
)

Potential energy of the system = −mgl cos ɵ

Hence the Lagrangian is given by

L =

1
2

(m + M)ẋ

2 − mẋlɵ̇cosɵ +

1
2

l

2ɵ̇

2m + mgl cos ɵ --- (1)

Equations that represent the dynamics of the system are given by

d
dt (

∂L
∂ẋ

) −

∂L
∂x = F − − (2)

d
dt (

∂L
∂ɵ̇

) −

∂L
∂ɵ
= 0 | − − (3)
(2) −> | (m + M)ẍ− mlɵ̈cosɵ + lɵ̇
2msinɵ = F | − − (4)
(3) −> | −mẍcos ɵ + mlɵ̈+ mg sin ɵ = 0 | − − (5)
from (5) | ɵ̈=

−g sin ɵ+ ẍcos ɵ
l

− − (6)

(6) in (4) → ẋ2 = ẍ=

F− mg sin ɵ cos ɵ − mlɵ̇

2
sinɵ
M+m(1−cos² ɵ)

− − (7)

(4) in (6) → ẋ4 = ɵ̈=

−(m+M)g sin ɵ + F cos ɵ −

mlɵ̇

2 sin2ɵ
2
L(M+m(1−cos² ɵ))

− − (8)

Q12) How many equilibrium points does the inverted cart pendulum system have?
Categorize them as stable or unstable? | (3)

There are two equilibrium points i. (0 0 0 0) ii. (0 0 π 0).

For the first point matrix A − λI is given by,

A − λI =

[

−λ | 1 | 0 | 0
0 | −λ | −m ∗

g
M
| | | 0
0 | 0 | −λ | 1
0 | 0 | −(m + M)

g
LM −λ
]

Its eigenvalues are,

[

0
−i√
(M + m)g
LM
i√
(M + m)g
LM ]

For the second point matrix A − λI is given by,

A − λI =

[

−λ | 1 | 0 | 0
0 | −λ | −m ∗

g
M
| | | 0
0 | 0 | −λ | 1
0 | 0 | (m + M)

g
LM −λ
]

Its eigenvalues are,

[

0
−√
(M + m)g
LM
√
(M + m)g
LM ]

As shown above point (0 0 0 0) is stable equilibrium since its eigenvalues are on LHS of the S-plane, and (0 0 π 0) is an unstable equilibrium point since one its eigenvalues is on the RHS of the S-plane an also after a small change in the parameters around that point, the pendulum will not return to that point again unless there is an external force.
