iamAkshayrao/LQR-BalanceBot/Images/BalanceBot.jpg

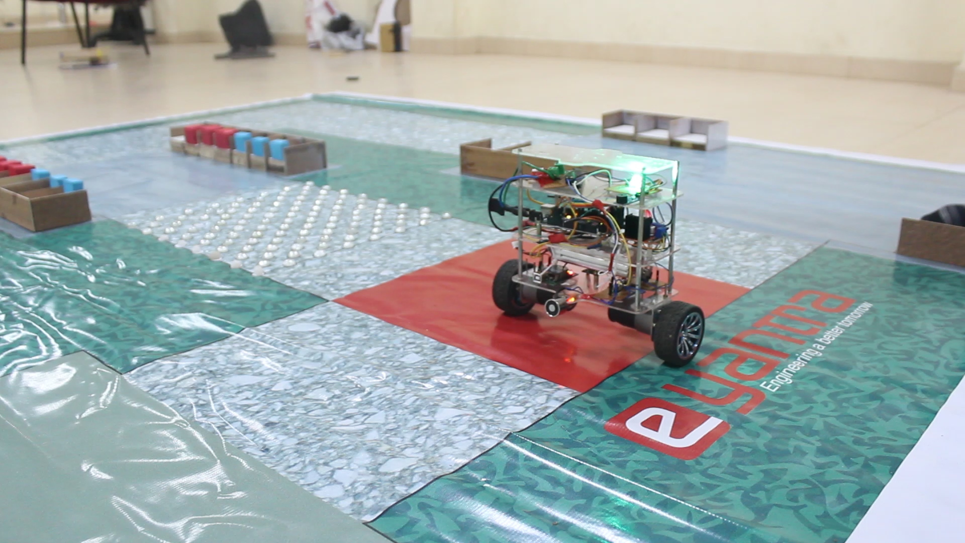
Images/BalanceBot.jpg
