iamAkshayrao/LQR-BalanceBot/Images/HardwareSchematics.png

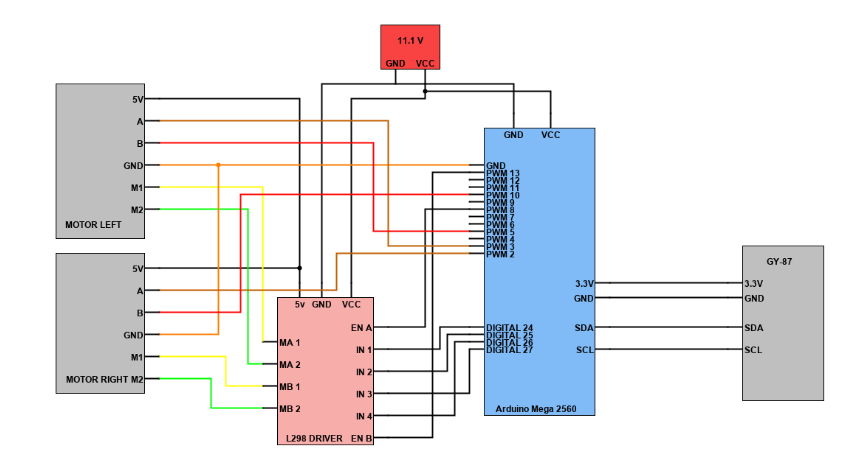
Images/HardwareSchematics.png
