iamAkshayrao/LQR-BalanceBot/Images/ProgramFlowChart.png

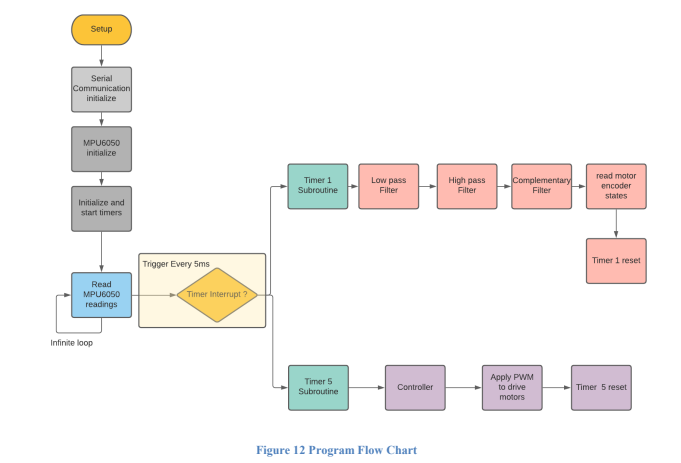
Images/ProgramFlowChart.png
