iamAkshayrao/LQR-BalanceBot/Images/sequenceDiagram1.png

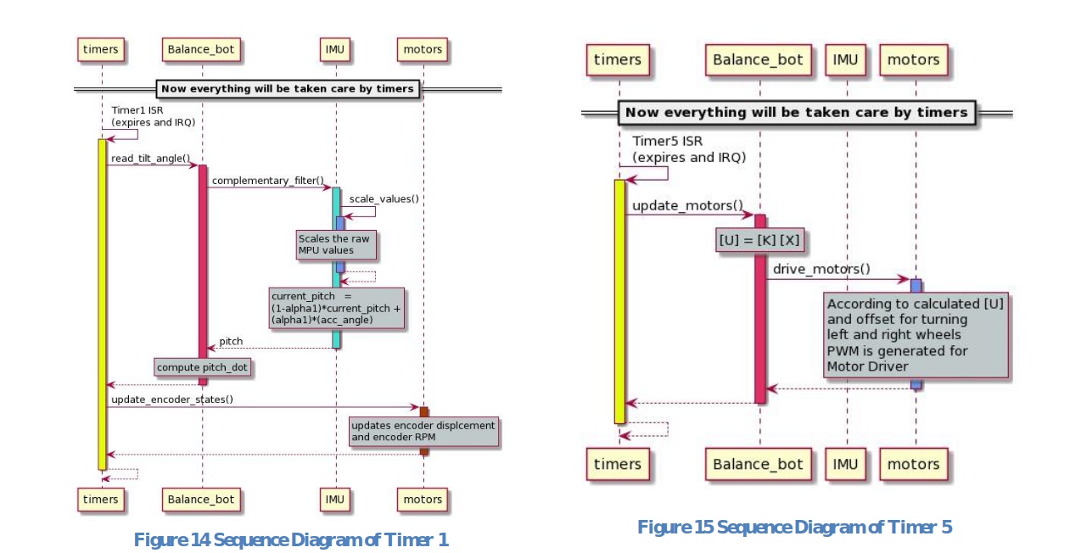
Images/sequenceDiagram1.png
