iamAkshayrao/LQR-BalanceBot/Images/SequenceDiagram2.png

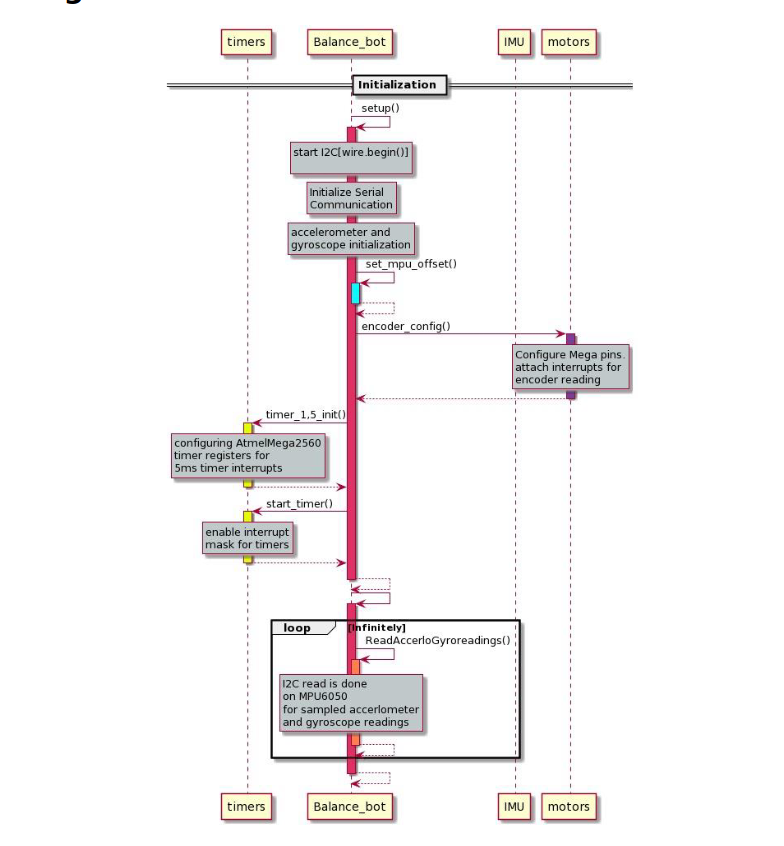
Images/SequenceDiagram2.png
