iamAkshayrao/LQR-BalanceBot/(commit log)

2020-05-14 update arduino code
2022-12-24 add MPU test files
    [csv_matter.csv, csv_output.csv, output_data.csv]
